st1na/robot_arm/README.md

# robot_arm
READ Doc.pdf for more info. Language Bulgarian.
