st1na/robot_arm/hardware/servos_control_schem/servos_control_schem.html

# /media/st1na/Shared/Projects/6dof_arm/hardware/servos_control_schem/servos_control_schem.sch

Mon 25 Mar 2019 11:13:45 PM EET

Eeschema 5.0.2-bee76a0~70~ubuntu18.04.1

Component Count:86

Ref | Qnty | Value | Part | Datasheet | Description | Vendor
C1, C14 | 2 | 100nF | Device:C_Small | ~ | Unpolarized capacitor, small symbol
C2, C6 | 2 | 100uF | Device:CP_Small | ~ | Polarized capacitor, small symbol
C3, C4 | 2 | 18pF | Device:C_Small | ~ | Unpolarized capacitor, small symbol
C5 | 1 | 10nF | Device:C_Small | ~ | Unpolarized capacitor, small symbol
C7, C8, C9, C10, C12, C13 | 6 | 10uF | Device:C_Small | ~ | Unpolarized capacitor, small symbol
C11 | 1 | 27pF | Device:C_Small | ~ | Unpolarized capacitor, small symbol
C15, C16, C17, C18, C19, C20 | 6 | 0.1uF | Device:C_Small | ~ | Unpolarized capacitor, small symbol
CSEN1, CSEN2, CSEN3, CSEN4, CSEN5, CSEN6 | 6 | 1x3 | Jumper:Jumper_3_Bridged12 | ~ | Jumper, 3-pole, pins 1+2 closed/bridged
CT1 | 1 | 470pF | Device:C_Small | ~ | Unpolarized capacitor, small symbol
Co1 | 1 | 470uF | Device:CP | ~ | Polarized capacitor
D1 | 1 | 1N5822 | Diode:1N5822 | http://www.vishay.com/docs/88526/1n5820.pdf | 40V 3A Schottky Barrier Rectifier Diode, DO-201AD
D2 | 1 | LED_R | Device:LED | ~ | Light emitting diode
D3 | 1 | LED_G | Device:LED | ~ | Light emitting diode
D4 | 1 | LED_B | Device:LED | ~ | Light emitting diode
J1 | 1 | ICSP_conn | Connector_Generic:Conn_02x03_Odd_Even | ~ | Generic connector, double row, 02x03, odd/even pin numbering scheme (row 1 odd numbers, row 2 even numbers), script generated (kicad-library-utils/schlib/autogen/connector/)
J2 | 1 | rpi connector | Connector_Generic:Conn_02x20_Odd_Even | ~ | Generic connector, double row, 02x20, odd/even pin numbering scheme (row 1 odd numbers, row 2 even numbers), script generated (kicad-library-utils/schlib/autogen/connector/)
J3 | 1 | PW_IN | Connector:Screw_Terminal_01x02 | ~ | Generic screw terminal, single row, 01x02, script generated (kicad-library-utils/schlib/autogen/connector/)
L1 | 1 | 1uH | Device:L_Small | ~ | Inductor, small symbol
L2 | 1 | 47uH/2A | Device:L_Small | ~ | Inductor, small symbol
L3 | 1 | 4.7uH/2A | Device:L_Small | ~ | Inductor, small symbol
M1, M2, M3, M4, M5, M6 | 6 | Motor_Servo | Motor:Motor_Servo | http://forums.parallax.com/uploads/attachments/46831/74481.png | Servo Motor (Futaba, HiTec, JR connector)
R1 | 1 | 10KR | Device:R_Small | ~ | Resistor, small symbol
R2 | 1 | 50KR | Device:R_Small | ~ | Resistor, small symbol
R3, RG1, RG2, RG3, RG4, RG5, RG6 | 7 | 1KR | Device:R | ~ | Resistor
R4 | 1 | 3KR | Device:R_Small | ~ | Resistor, small symbol
R5, R6, R7 | 3 | 330R | Device:R | ~ | Resistor
R8, R9, R10 | 3 | 510R | Device:R_Small | ~ | Resistor, small symbol
R11, R12 | 2 | 4.7KR | Device:R_Small | ~ | Resistor, small symbol
R13 | 1 | 976KR | Device:R_Small | ~ | Resistor, small symbol
R14 | 1 | 309KR | Device:R_Small | ~ | Resistor, small symbol
RESET1 | 1 | SW_Push | Switch:SW_Push | | Push button switch, generic, two pins
RF1, RF2, RF3, RF4, RF5, RF6 | 6 | 27KR | Device:R | ~ | Resistor
RShunt1, RShunt2, RShunt3, RShunt4, RShunt5, RShunt6 | 6 | 100mR | Device:R | ~ | Resistor
Rsc1 | 1 | 0.22R | Device:R_Small | ~ | Resistor, small symbol
U1 | 1 | MC34063AD | Regulator_Switching:MC34063AD | http://www.onsemi.com/pub_link/Collateral/MC34063A-D.PDF | 1.5A, step-up/down/inverting switching regulator, 3-40V Vin, 100kHz, SO-8
U2 | 1 | ATmega328PB-AU | ATmega328PB-AU:ATmega328PB-AU | http://ww1.microchip.com/downloads/en/DeviceDoc/40001906C.pdf | 20MHz, 32kB Flash, 2kB SRAM, 1kB EEPROM, TQFP-32
U3 | 1 | MCP1642B|D-ADJ | servos_control_schem-rescue:MCP1642B|D-ADJ-Regulator_SwitchingMCP1642B|D-ADJ | http://ww1.microchip.com/downloads/en/DeviceDoc/20002234D.pdf
U4 | 1 | LT1117-3.3 | Regulator_Linear:LT1117-3.3 | http://cds.linear.com/docs/en/datasheet/1117fd.pdf | 800mA Low-Dropout Linear Regulator, 3.3V fixed output, SOT-223/TO-263
U5, U6, U7 | 3 | NE5532 | Amplifier_Operational:NE5532 | http://www.ti.com/lit/ds/symlink/ne5532.pdf | Dual Low-Noise Operational Amplifiers, DIP-8/SOIC-8
Y1 | 1 | 16 MHz | Device:Crystal_Small | ~ | Two pin crystal, small symbol
