st1na/robot_arm/software/ros_packages/robot_urdf/meshes/hand_left_finger.STL

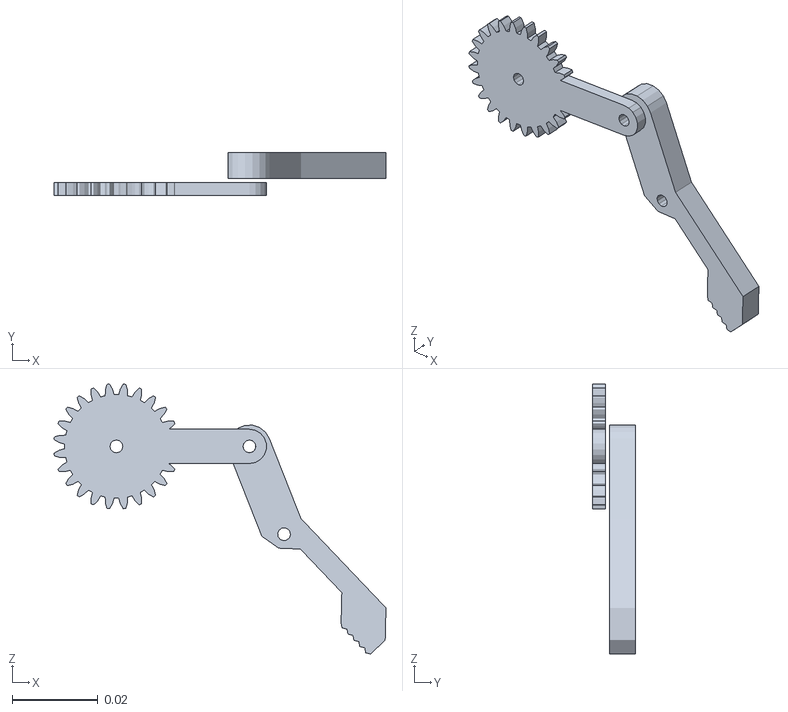
[picture p23: CAD file, 2019-04-23]
software/ros_packages/robot_urdf/meshes/hand_left_finger.STL
0.0774 x 0.01 x 0.0629
