st1na/robot_arm/software/ros_packages/robot_urdf/meshes/hand_right_finger.STL

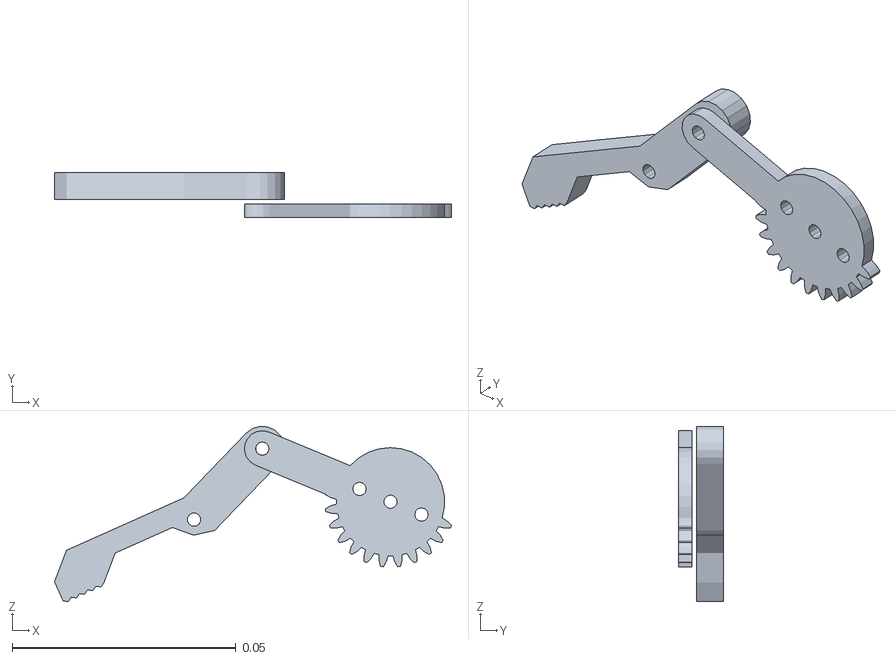
[picture p24: CAD file, 2019-04-23]
software/ros_packages/robot_urdf/meshes/hand_right_finger.STL
0.0887 x 0.01 x 0.0391
