st1na/robot_arm/software/ros_packages/robot_urdf/meshes/hand_base.STL

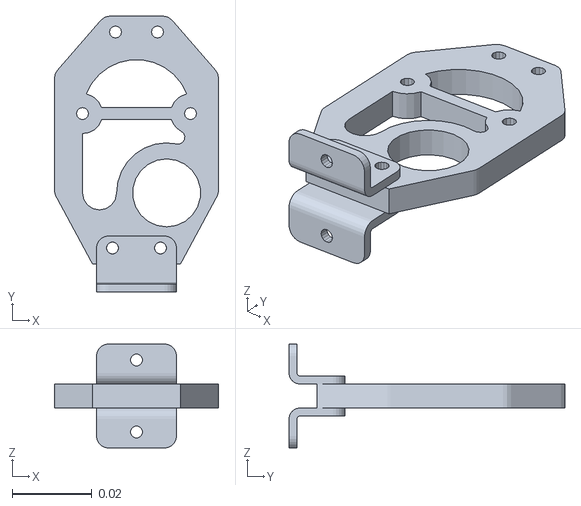
[picture p25: CAD file, 2019-04-23]
software/ros_packages/robot_urdf/meshes/hand_base.STL
0.041 x 0.069 x 0.026
