st1na/robot_arm/hardware/servos_control_schem/servos_control_schem.pdf

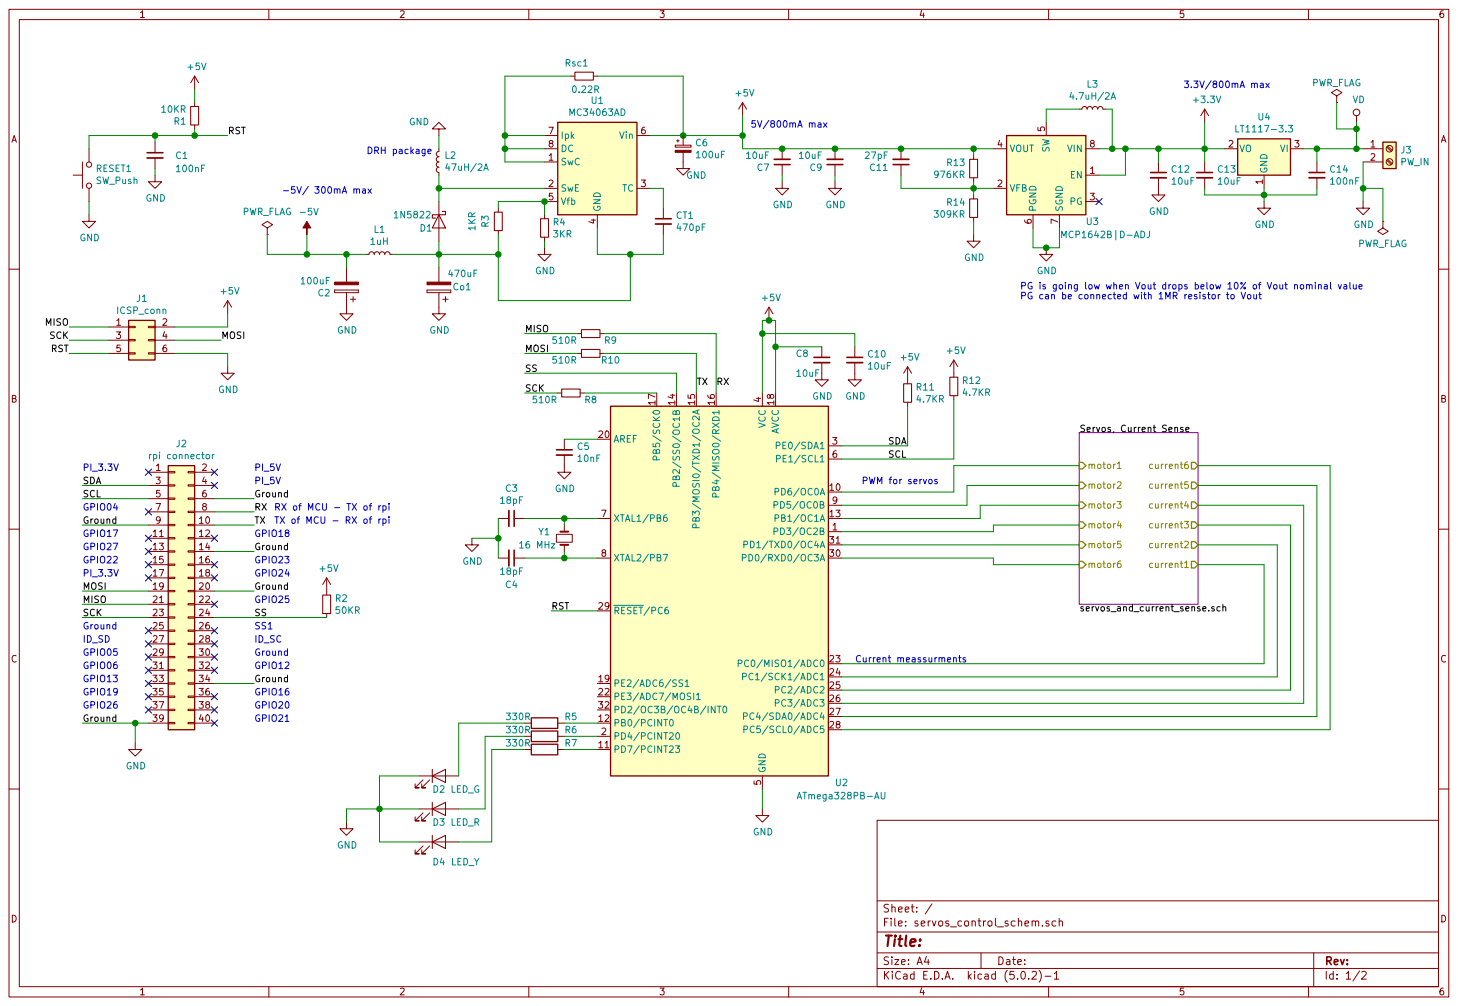
[picture p26: page 1]

PG is going low when Vout drops below 10% of Vout nominal value PG can be connected with 1MR resistor to Vout R11

330R | R6
330R | R7

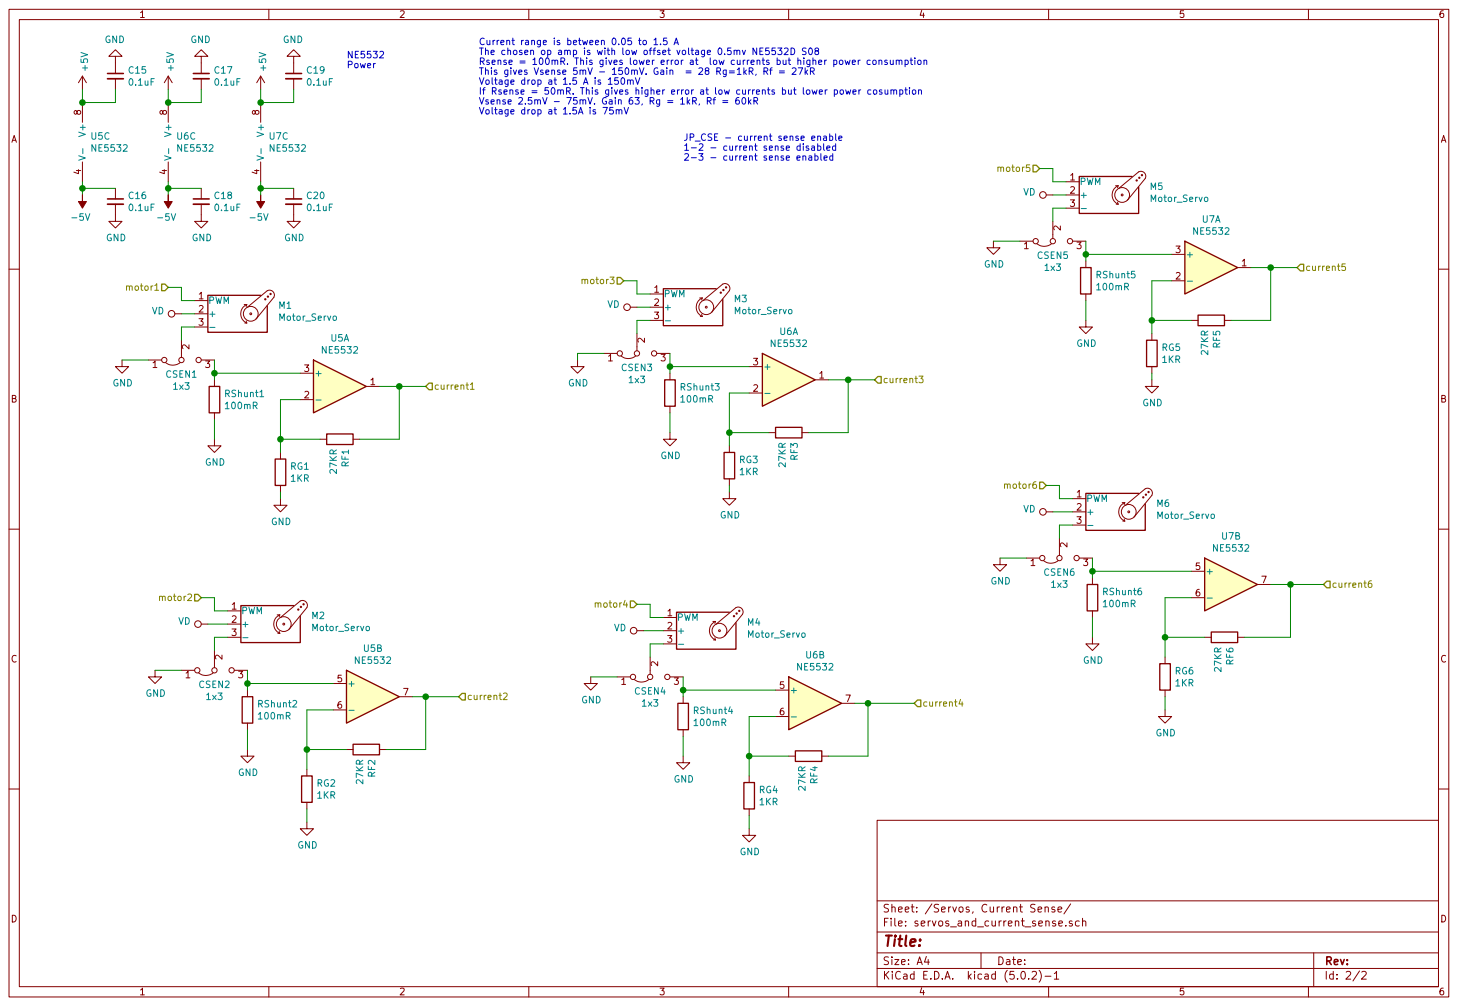
[picture p27: page 2]

The chosen op amp is with low offset voltage 0.5mv NE5532D S08
Rsense = 100mR. This gives lower error at low currents but higher power consumption
This gives Vsense 5mV - 150mV. Gain = 28 Rg=1kR, Rf = 27kR
Voltage drop at 1.5 A is 150mV
If Rsense = 50mR. This gives higher error at low currents but lower power cosumption
Vsense 2.5mV - 75mV. Gain 63, Rg = 1kR, Rf = 60kR
Voltage drop at 1.5A is 75mV

Sheet: /Servos, Current Sense/
File: servos_and_current_sense.sch
Id: 2/2 Title:
