st1na/robot_arm/hardware/servos_control_schem/servos_control_schem.kicad_pcb

## KiCad design hardware/servos_control_schem/servos_control_schem.kicad_pcb (2019-04-23)

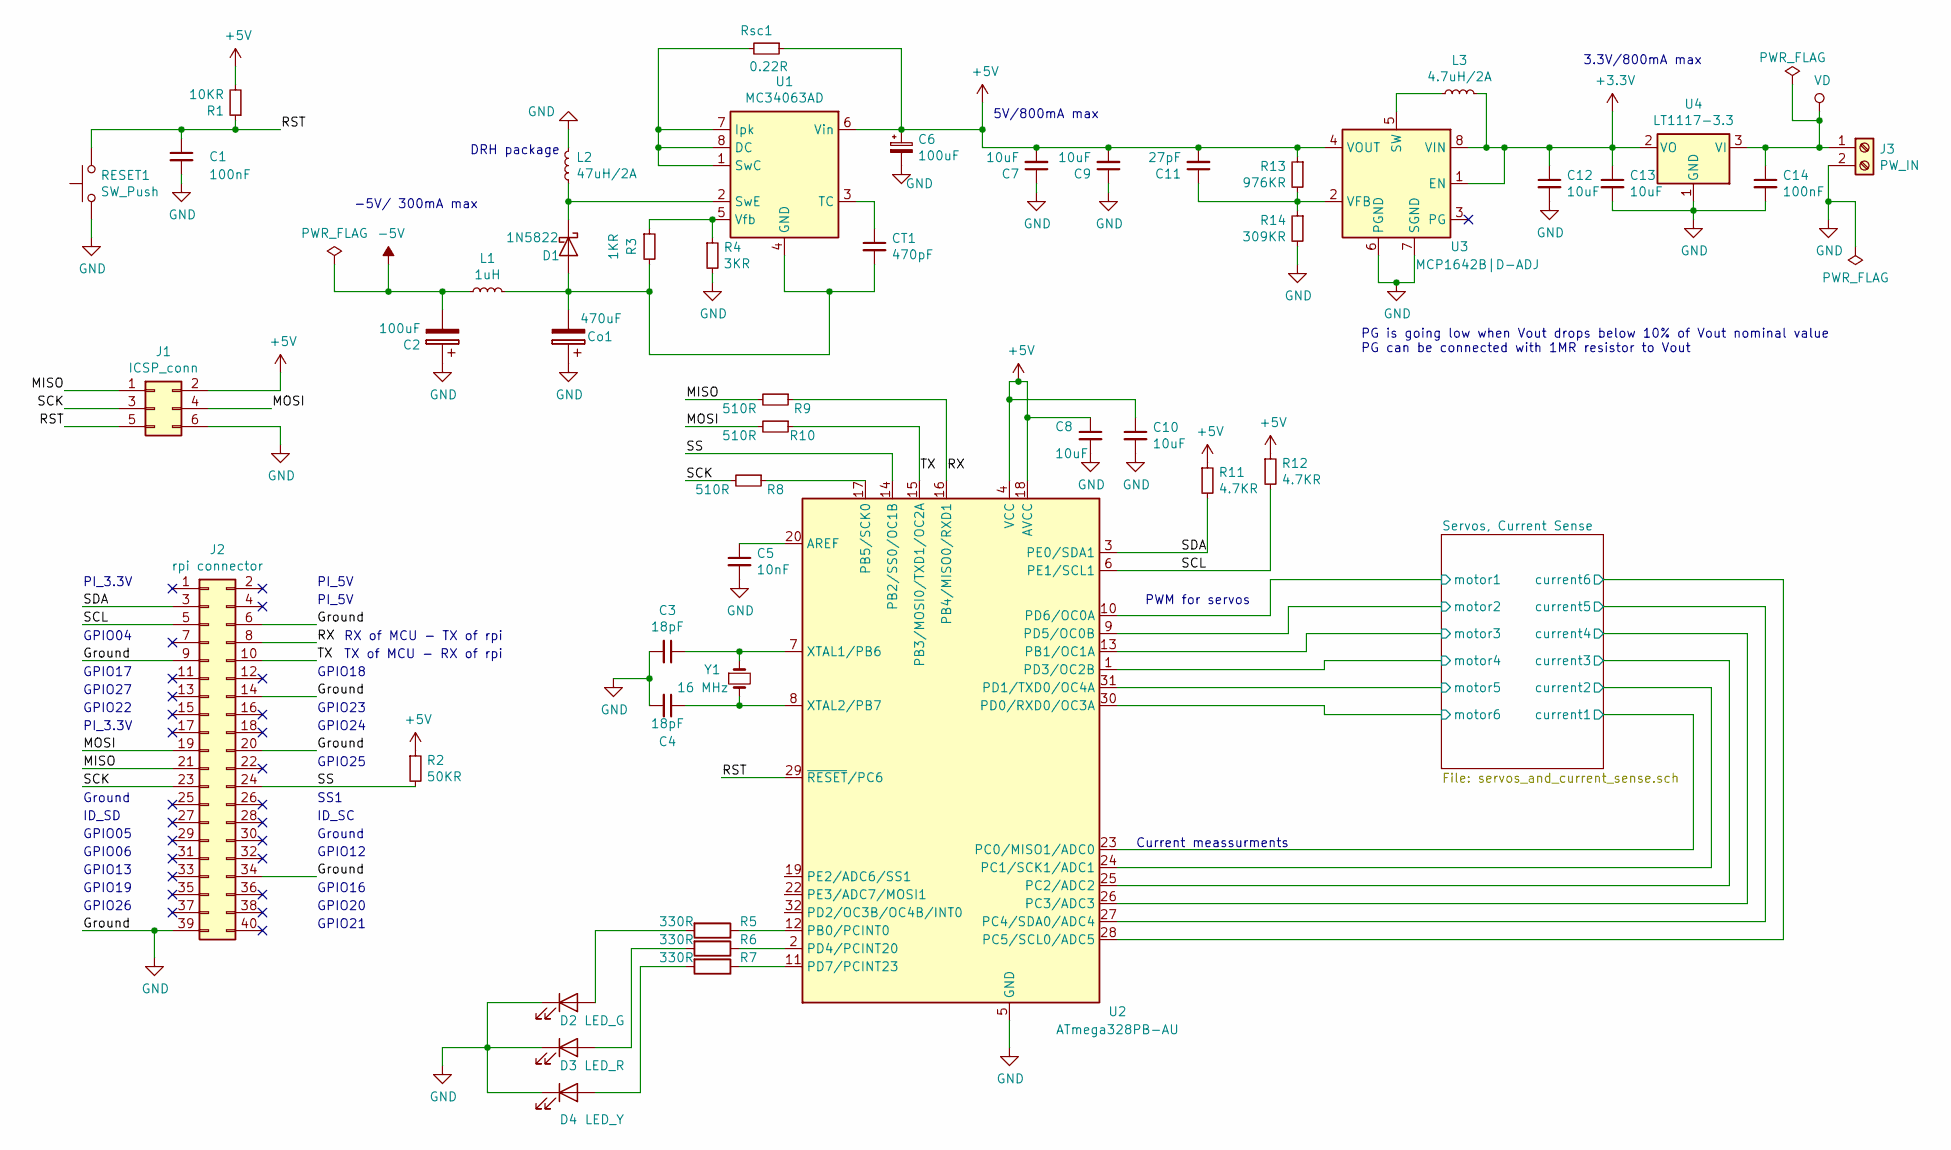
[picture p28: schematic servos_control_schem.sch]

Parts:
C1, C14: 100nF; C_0805_2012Metric_Pad1.15x1.40mm_HandSolder
C2, C6: 100uF; CP_Elec_6.3x5.4
C3, C4: 18pF; C_0805_2012Metric_Pad1.15x1.40mm_HandSolder
C5: 10nF; C_0805_2012Metric_Pad1.15x1.40mm_HandSolder
C7, C8, C9, C10, C12, C13: 10uF; C_0805_2012Metric_Pad1.15x1.40mm_HandSolder
C11: 27pF; C_0805_2012Metric_Pad1.15x1.40mm_HandSolder
CT1: 470pF; C_0805_2012Metric_Pad1.15x1.40mm_HandSolder
Co1: 470uF; CP_Elec_6.3x7.7
D1: 1N5822; D_SMC
D2: LED_G; LED_1206_3216Metric_Pad1.42x1.75mm_HandSolder
D3: LED_R; LED_1206_3216Metric_Pad1.42x1.75mm_HandSolder
D4: LED_Y; LED_1206_3216Metric_Pad1.42x1.75mm_HandSolder
J1: ICSP_conn; IDC-Header_2x03_P2.54mm_Vertical
J2: rpi connector; IDC-Header_2x20_P2.54mm_Vertical
J3: PW_IN; TerminalBlock_bornier-2_P5.08mm
L1: 1uH; L_1210_3225Metric_Pad1.42x2.65mm_HandSolder
L2: 47uH/2A; L_12x12mm_H6mm
L3: 4.7uH/2A; L_7.3x7.3_H3.5
R1: 10KR; R_0805_2012Metric_Pad1.15x1.40mm_HandSolder
R2: 50KR; R_0805_2012Metric_Pad1.15x1.40mm_HandSolder
R3: 1KR; R_0805_2012Metric_Pad1.15x1.40mm_HandSolder
R4: 3KR; R_0805_2012Metric_Pad1.15x1.40mm_HandSolder
R5, R6, R7: 330R; R_0805_2012Metric_Pad1.15x1.40mm_HandSolder
R8, R9, R10: 510R; R_0805_2012Metric_Pad1.15x1.40mm_HandSolder
R11, R12: 4.7KR; R_0805_2012Metric_Pad1.15x1.40mm_HandSolder
R13: 976KR; R_0805_2012Metric_Pad1.15x1.40mm_HandSolder
R14: 309KR; R_0805_2012Metric_Pad1.15x1.40mm_HandSolder
RESET1: SW_Push; SW_SPST_FSMSM
Rsc1: 0.22R; R_0805_2012Metric_Pad1.15x1.40mm_HandSolder
U1: MC34063AD; SOIC-8_3.9x4.9mm_P1.27mm
U2: ATmega328PB-AU; TQFP-32_7x7mm_P0.8mm
U3: MCP1642B|D-ADJ; MSOP-8_3x3mm_P0.65mm
U4: LT1117-3.3; SOT-223
Y1: 16 MHz; Crystal_SMD_HC49-SD

Connections:
+3V3: C12.1, C13.1, L3.1, U3.1 (EN), U3.8 (VIN), U4.2 (VO)
+5V: C6.1, C7.2, C8.1, C9.2, C10.1, C11.2, J1.2, R1.2, R2.1, R11.1, R12.1, R13.1, Rsc1.1, U1.6 (Vin), U2.4 (VCC), U2.18 (AVCC), U3.4 (VOUT); also elsewhere on the board
-5V: C2.2, L1.1; also elsewhere on the board
/MISO: J1.1, J2.21, R9.2
/MOSI: J1.4, J2.19, R10.2
/RST: C1.1, J1.5, R1.1, RESET1.2, U2.29 (~RESET~/PC6)
/RX: J2.8, R9.1, U2.16 (PB4/MISO0/RXD1)
/SCK: J1.3, J2.23, R8.2
/SCL: J2.5, R12.2, U2.6 (PE1/SCL1)
/SDA: J2.3, R11.2, U2.3 (PE0/SDA1)
/SS: J2.24, R2.2, U2.14 (PB2/SS0/OC1B)
/Servos, Current Sense/current1: U2.23 (PC0/MISO1/ADC0); also elsewhere on the board
/Servos, Current Sense/current2: U2.24 (PC1/SCK1/ADC1); also elsewhere on the board
/Servos, Current Sense/current3: U2.25 (PC2/ADC2); also elsewhere on the board
/Servos, Current Sense/current4: U2.26 (PC3/ADC3); also elsewhere on the board
/Servos, Current Sense/current5: U2.27 (PC4/SDA0/ADC4); also elsewhere on the board
/Servos, Current Sense/current6: U2.28 (PC5/SCL0/ADC5); also elsewhere on the board
/Servos, Current Sense/motor1: U2.10 (PD6/OC0A); also elsewhere on the board
/Servos, Current Sense/motor2: U2.9 (PD5/OC0B); also elsewhere on the board
/Servos, Current Sense/motor3: U2.13 (PB1/OC1A); also elsewhere on the board
/Servos, Current Sense/motor4: U2.1 (PD3/OC2B); also elsewhere on the board
/Servos, Current Sense/motor5: U2.31 (PD1/TXD0/OC4A); also elsewhere on the board
/Servos, Current Sense/motor6: U2.30 (PD0/RXD0/OC3A); also elsewhere on the board
/TX: J2.10, R10.1, U2.15 (PB3/MOSI0/TXD1/OC2A)
GND: C1.2, C2.1, C3.2, C4.2, C5.2, C6.2, C7.1, C8.2, C9.1, C10.2, C12.2, C13.2, C14.2, Co1.1, D2.1 (K), D3.1 (K), D4.1 (K), J1.6, J2.6, J2.9, J2.14, J2.20, J2.34, J2.39, J3.2, L2.2, R4.2, R14.2, RESET1.1, U2.5 (GND), U2.21 (GND), U3.6 (PGND), U3.7 (SGND), U4.1 (GND); also elsewhere on the board
unnamed: C3.1, U2.7 (XTAL1/PB6), Y1.1
unnamed: C4.1, U2.8 (XTAL2/PB7), Y1.2
unnamed: C5.1, U2.20 (AREF)
unnamed: C11.1, R13.2, R14.1, U3.2 (VFB)
unnamed: CT1.1, U1.3 (TC)
unnamed: CT1.2, Co1.2, D1.2 (A), L1.2, R3.2, U1.4 (GND)
unnamed: D1.1 (K), L2.1, U1.2 (SwE)
unnamed: D2.2 (A), R5.2
unnamed: D3.2 (A), R6.2
unnamed: D4.2 (A), R7.2
unnamed: L3.2, U3.5 (SW)
unnamed: R3.1, R4.1, U1.5 (Vfb)
unnamed: R5.1, U2.12 (PB0/PCINT0)
unnamed: R6.1, U2.2 (PD4/PCINT20)
unnamed: R7.1, U2.11 (PD7/PCINT23)
unnamed: R8.1, U2.17 (PB5/SCK0)
unnamed: Rsc1.2, U1.1 (SwC), U1.7 (Ipk), U1.8 (DC)
VD: C14.1, J3.1, U4.3 (VI); also elsewhere on the board

Notes on the sheet:
PWM for servos
Current meassurments
5V/800mA max
3.3V/800mA max
RX of MCU - TX of rpi
TX of MCU - RX of rpi
PG is going low when Vout drops below 10% of Vout nominal value PG can be connected with 1MR resistor to Vout
-5V/ 300mA max
DRH package
PI_3.3V
GPIO04
GPIO17
GPIO27
GPIO22
Ground
ID_SD
GPIO05
GPIO06
GPIO13
GPIO19
GPIO26
PI_5V
GPIO18
GPIO23
GPIO24
GPIO25
SS1
ID_SC
GPIO12
GPIO16
GPIO20
GPIO21

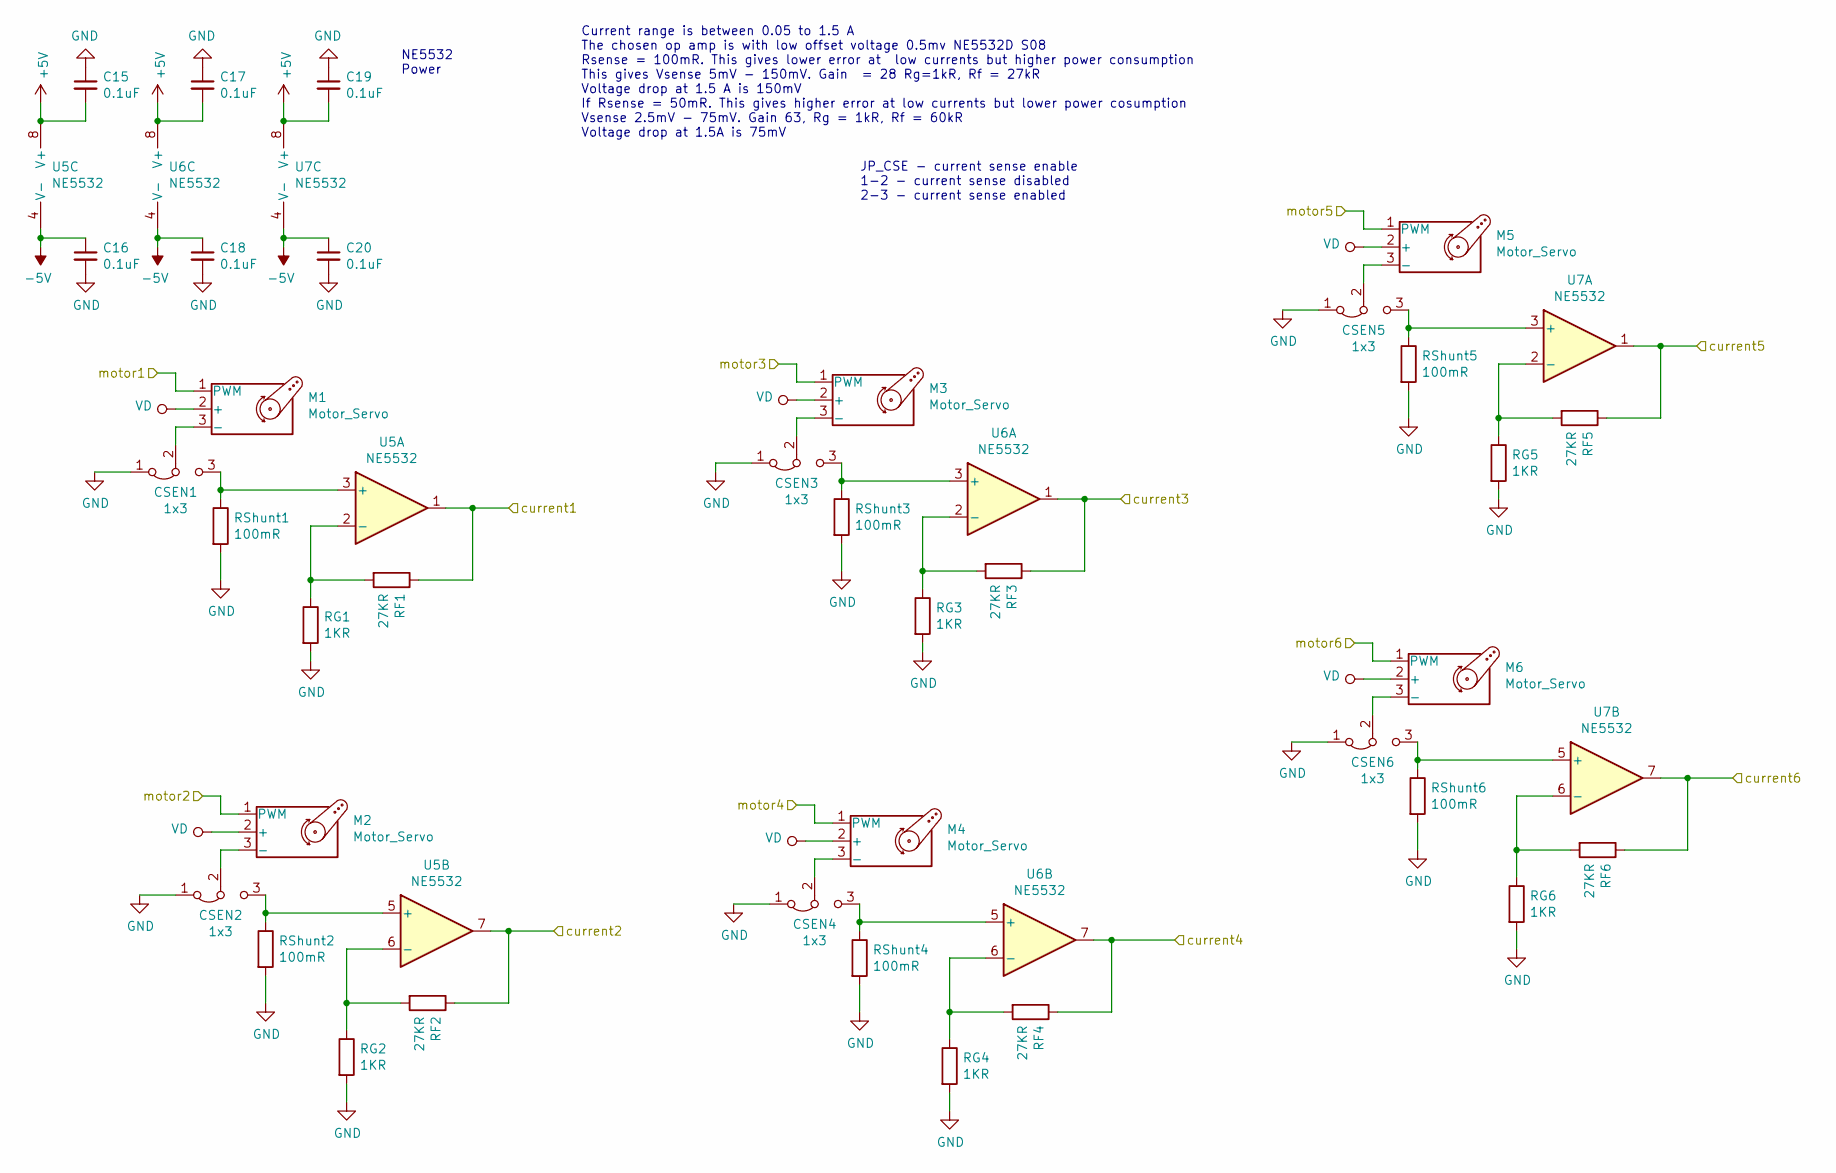
[picture p29: schematic servos_and_current_sense.sch]

Parts:
C15, C16, C17, C18, C19, C20: 0.1uF; C_0805_2012Metric_Pad1.15x1.40mm_HandSolder
CSEN1, CSEN2, CSEN3, CSEN4, CSEN5, CSEN6: 1x3; PinHeader_1x03_P2.54mm_Vertical
M1, M2, M3, M4, M5, M6: Motor_Servo; PinHeader_1x03_P2.54mm_Vertical
RF1, RF2, RF3, RF4, RF5, RF6: 27KR; R_0805_2012Metric_Pad1.15x1.40mm_HandSolder
RG1, RG2, RG3, RG4, RG5, RG6: 1KR; R_0805_2012Metric_Pad1.15x1.40mm_HandSolder
RShunt1, RShunt2, RShunt3, RShunt4, RShunt5, RShunt6: 100mR; R_2512_6332Metric_Pad1.52x3.35mm_HandSolder
U5, U6, U7: NE5532; SOIC-8_3.9x4.9mm_P1.27mm

Connections:
+5V: C15.2, C17.2, C19.2, U5.8 (V+), U6.8 (V+), U7.8 (V+); also elsewhere on the board
-5V: C16.1, C18.1, C20.1, U5.4 (V-), U6.4 (V-), U7.4 (V-); also elsewhere on the board
/Servos, Current Sense/current1: RF1.1, U5.1; also elsewhere on the board
/Servos, Current Sense/current2: RF2.1, U5.7; also elsewhere on the board
/Servos, Current Sense/current3: RF3.1, U6.1; also elsewhere on the board
/Servos, Current Sense/current4: RF4.1, U6.7; also elsewhere on the board
/Servos, Current Sense/current5: RF5.1, U7.1; also elsewhere on the board
/Servos, Current Sense/current6: RF6.1, U7.7; also elsewhere on the board
/Servos, Current Sense/motor1: M1.1 (PWM); also elsewhere on the board
/Servos, Current Sense/motor2: M2.1 (PWM); also elsewhere on the board
/Servos, Current Sense/motor3: M3.1 (PWM); also elsewhere on the board
/Servos, Current Sense/motor4: M4.1 (PWM); also elsewhere on the board
/Servos, Current Sense/motor5: M5.1 (PWM); also elsewhere on the board
/Servos, Current Sense/motor6: M6.1 (PWM); also elsewhere on the board
GND: C15.1, C16.2, C17.1, C18.2, C19.1, C20.2, CSEN1.1 (A), CSEN2.1 (A), CSEN3.1 (A), CSEN4.1 (A), CSEN5.1 (A), CSEN6.1 (A), RG1.2, RG2.2, RG3.2, RG4.2, RG5.2, RG6.2, RShunt1.2, RShunt2.2, RShunt3.2, RShunt4.2, RShunt5.2, RShunt6.2; also elsewhere on the board
unnamed: CSEN1.2 (C), M1.3 (-)
unnamed: CSEN1.3 (B), RShunt1.1, U5.3 (+)
unnamed: CSEN2.2 (C), M2.3 (-)
unnamed: CSEN2.3 (B), RShunt2.1, U5.5 (+)
unnamed: CSEN3.2 (C), M3.3 (-)
unnamed: CSEN3.3 (B), RShunt3.1, U6.3 (+)
unnamed: CSEN4.2 (C), M4.3 (-)
unnamed: CSEN4.3 (B), RShunt4.1, U6.5 (+)
unnamed: CSEN5.2 (C), M5.3 (-)
unnamed: CSEN5.3 (B), RShunt5.1, U7.3 (+)
unnamed: CSEN6.2 (C), M6.3 (-)
unnamed: CSEN6.3 (B), RShunt6.1, U7.5 (+)
unnamed: RF1.2, RG1.1, U5.2 (-)
unnamed: RF2.2, RG2.1, U5.6 (-)
unnamed: RF3.2, RG3.1, U6.2 (-)
unnamed: RF4.2, RG4.1, U6.6 (-)
unnamed: RF5.2, RG5.1, U7.2 (-)
unnamed: RF6.2, RG6.1, U7.6 (-)
VD: M1.2 (+), M2.2 (+), M3.2 (+), M4.2 (+), M5.2 (+), M6.2 (+); also elsewhere on the board

Notes on the sheet:
NE5532 Power
Current range is between 0.05 to 1.5 A The chosen op amp is with low offset voltage 0.5mv NE5532D S08 Rsense = 100mR. This gives lower error at low currents but higher power consumption This gives Vsense 5mV - 150mV. Gain = 28 Rg=1kR, Rf = 27kR Voltage drop at 1.5 A is 150mV If Rsense = 50mR. This 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
JP_CSE - current sense enable 1-2 - current sense disabled 2-3 - current sense enabled

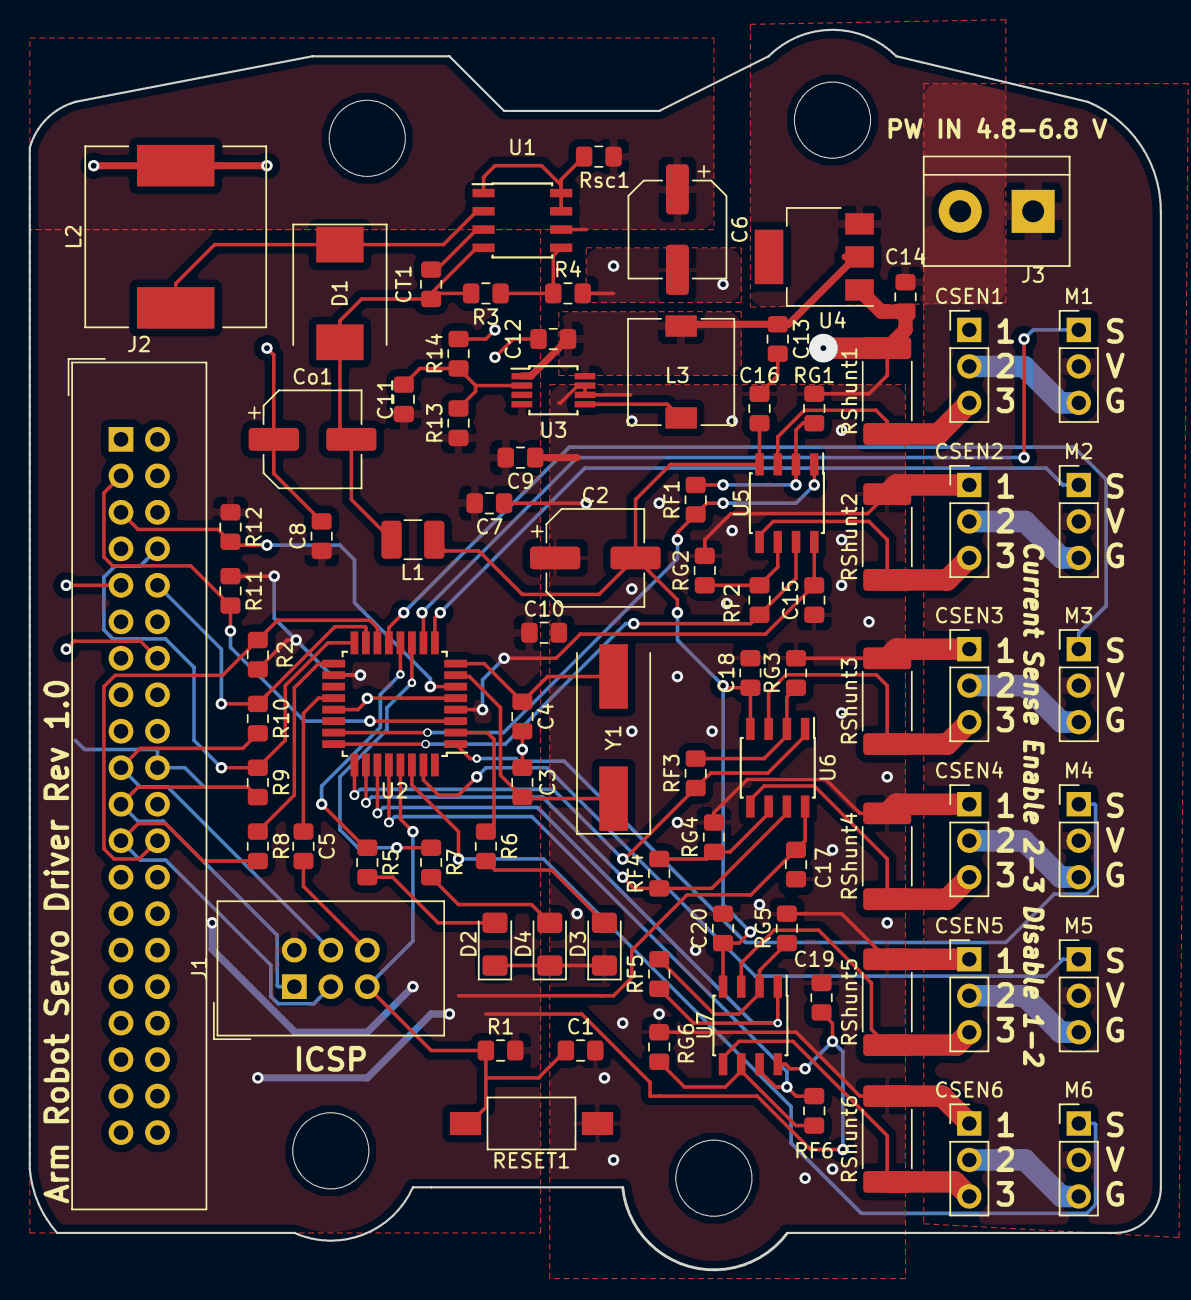
[picture p30: board servos_control_schem.kicad_pcb from above]

Board: 2 copper layers, 78.7 x 86.3 mm, 86 parts (0 on the bottom side), 61 nets.
