st1na/robot_arm/(commit log)

2019-04-23 URDF simple example
    [urdf_example.urdf]
2019-05-04 SPI enable
